rudiratlos/RPI_PowerMgmt/img/IMG_1169.jpg

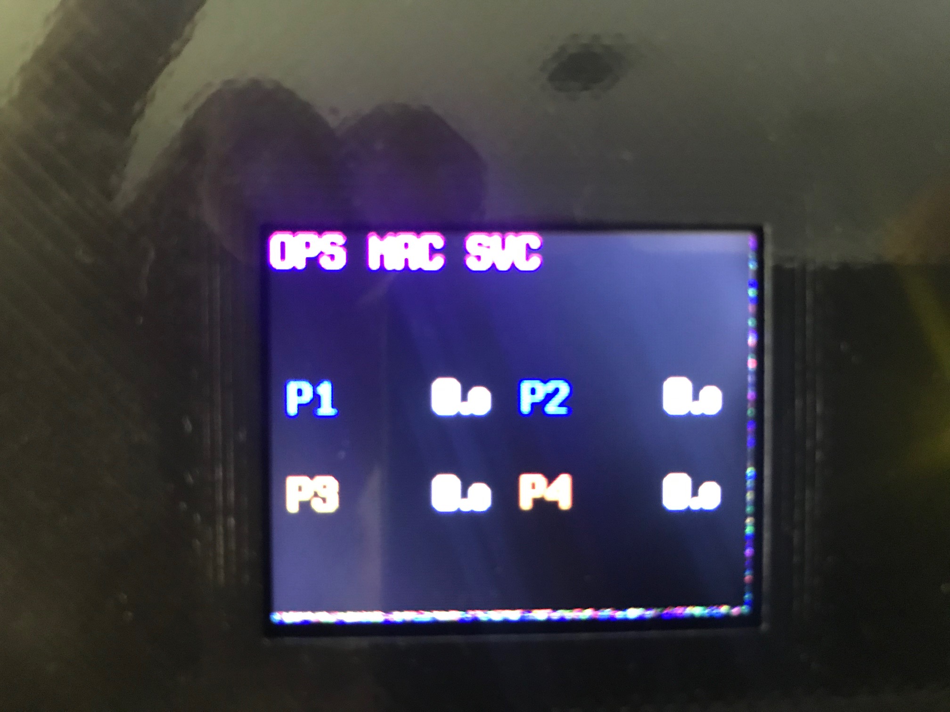
img/IMG_1169.jpg
