rudiratlos/RPI_PowerMgmt/(threads)

Thread 2 (2020-11-07):

Relay type

pablofrommars, 2020-11-07:
Thanks for your hard work, this is very useful!

Would you be able to share the types of relay you have tested in your project?

I am struggling to find appropriate ones complying with the power requirements of a Pi 4.

rudiratlos, 2020-11-08:
we are using:
BC850 (Transistor)
1kOhm
Diode
Omron G6RN (Realais 5DC)

rudiratlos, 2020-11-08:
Von meinem Smartphone gesendet,
Mit freundlichen Grüßen
Stefan Fischer

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

pablofrommars, 2020-11-09:
Thanks so much!

Closed 2020-11-09.
